igmr-lab/Digital_Galvo/README.md

# Digital Interface for Galvanometers

This project provides a low-cost interface for MachDSP-based galvanometer scanners.
See the manual in the doc folder for further instructions.
