igmr-lab/Digital_Galvo/src/PCB/PCB_2D.png

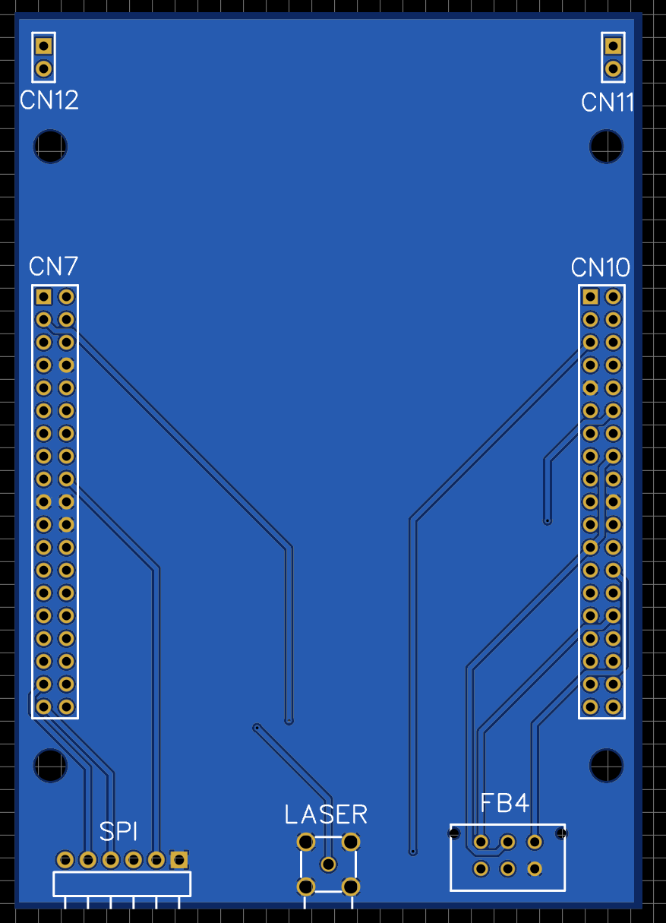
src/PCB/PCB_2D.png
