igmr-lab/Digital_Galvo/src/PCB/PCB_3D.png

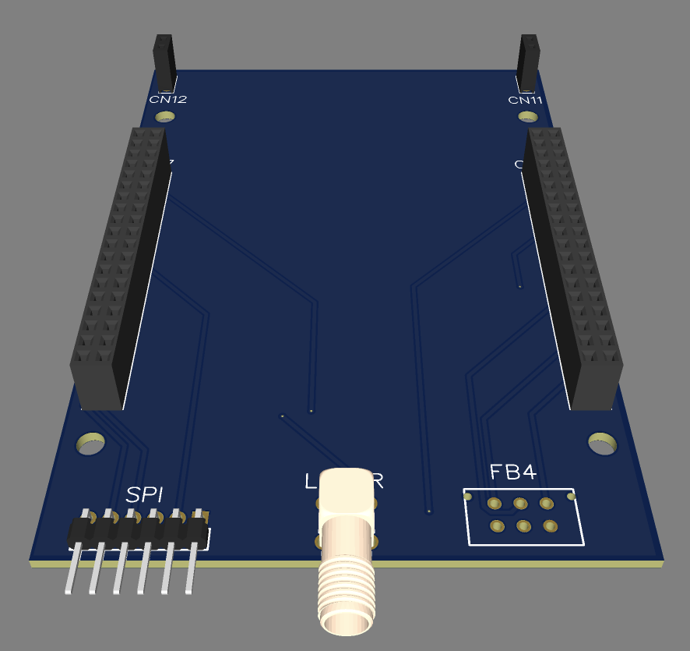
src/PCB/PCB_3D.png
