igmr-lab/Digital_Galvo/src/PCB/PCB_Bottom_Layer.png

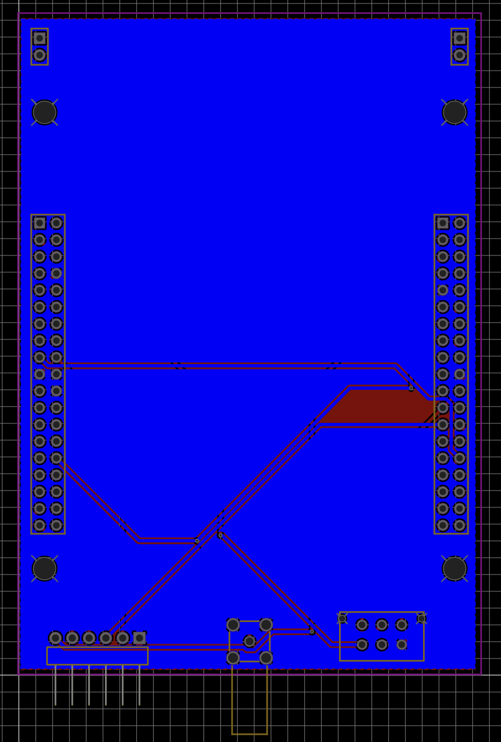
src/PCB/PCB_Bottom_Layer.png
