igmr-lab/Digital_Galvo/src/PCB/PCB_Design.png

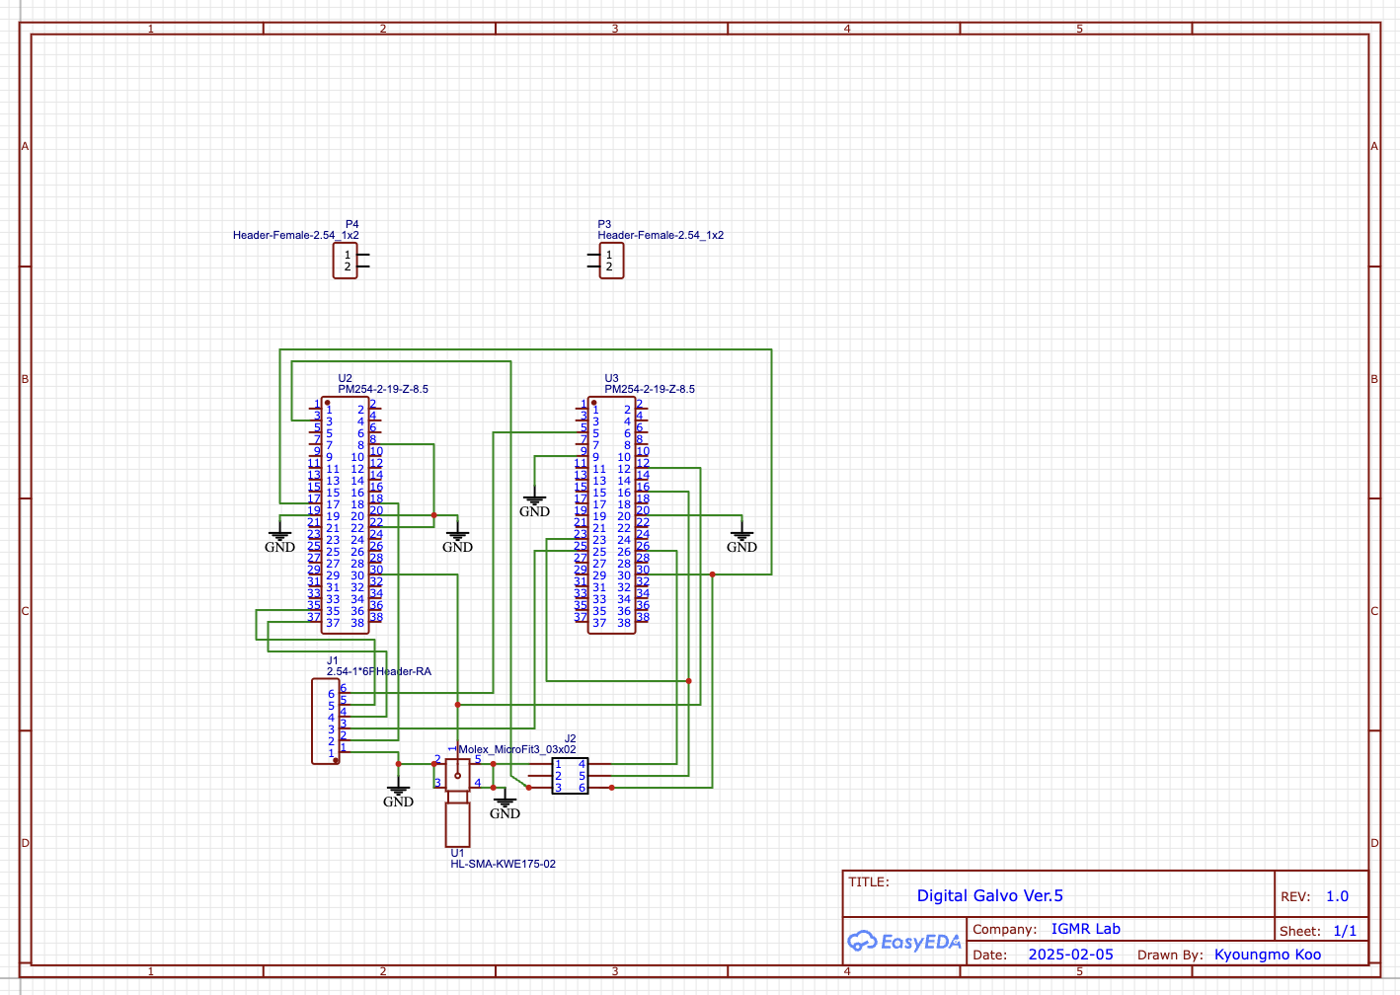
src/PCB/PCB_Design.png
