igmr-lab/Digital_Galvo/src/PCB/PCB_Top_Layer.png

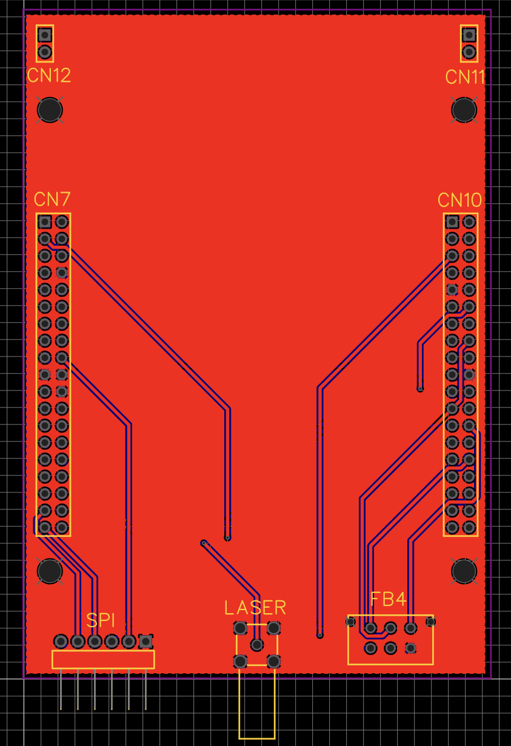
src/PCB/PCB_Top_Layer.png
