igmr-lab/Digital_Galvo/src/STM32/Core/Src/main.c

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
/* Includes ------------------------------------------------------------------*/
#include "main.h"

SAI_HandleTypeDef hsai_BlockA2;
SAI_HandleTypeDef hsai_BlockB2;
DMA_HandleTypeDef hdma_sai2_a;
DMA_HandleTypeDef hdma_sai2_b;

SPI_HandleTypeDef hspi2;
DMA_HandleTypeDef hdma_spi2_rx;
DMA_HandleTypeDef hdma_spi2_tx;

TIM_HandleTypeDef htim1;
TIM_HandleTypeDef htim2;
TIM_HandleTypeDef htim3;
DMA_HandleTypeDef hdma_tim1_ch1;

UART_HandleTypeDef huart1;
UART_HandleTypeDef huart2;
DMA_HandleTypeDef hdma_usart1_tx;
DMA_HandleTypeDef hdma_usart1_rx;
DMA_HandleTypeDef hdma_usart2_tx;
DMA_HandleTypeDef hdma_usart2_rx;

void SystemClock_Config(void);
void PeriphCommonClock_Config(void);
static void MX_GPIO_Init(void);
static void MX_DMA_Init(void);
static void MX_USART2_UART_Init(void);
static void MX_SAI2_Init(void);
static void MX_TIM1_Init(void);
static void MX_TIM2_Init(void);
static void MX_TIM3_Init(void);
static void MX_USART1_UART_Init(void);
static void MX_SPI2_Init(void);
/* USER CODE BEGIN PFP */
uint16_t pwmData[4] = {1, 0, 0, 0};
// uint16_t pwmData[8] = {1, 0, 0, 0, 0, 0, 0, 0};

int COUNT = 32 * 128;
int count = 2;
int BYTE_TO_BITS = 4;
int STATE_DIVIDER = 16;
uint32_t ID = 0x12345678;
uint8_t ping_buffer[4];

int PREP = 1;
int STREAM = 2;
int STOP = 3;
int PING = 4;

int SET_STATE = 1;
int STREAM_STATE = 2;
int STOP_STATE = 3;
int PING_STATE = 4;

int state = 0;
int next_state = 0;
int payload = 0;
int substate = 0;
int toggled = 0;
int NUM_OF_POSITIONS = 0;
int NUM_OF_POSITIONS_PER_CHUNK = 0;
int NUM_OF_BYTES_PER_CHUNK = 0;
int ping = 0;

int test2 = 0;

uint32_t test = 0;
uint32_t txData[6000];
uint32_t rxData[6000];
uint32_t StartByte;


/* USER CODE END PFP */

/* USER CODE BEGIN 0 */

void LED_Toggle(void){

	HAL_GPIO_TogglePin(GPIOA, GPIO_PIN_5);

}

void HAL_UART_TxCpltCallback (UART_HandleTypeDef *huart){

	if(count % 2 == 1){
		HAL_SPI_Transmit_DMA(&hspi2, rxData, NUM_OF_BYTES_PER_CHUNK);
	}
	else if(count % 2 == 0){
		HAL_SPI_Transmit_DMA(&hspi2, &rxData[NUM_OF_POSITIONS_PER_CHUNK], NUM_OF_BYTES_PER_CHUNK + BYTE_TO_BITS);
	}

}

void HAL_UART_RxCpltCallback (UART_HandleTypeDef *huart){

}

void SAI_TransmitReceive (uint16_t DataSize){

	HAL_SAI_Transmit_DMA(&hsai_BlockA2, (uint32_t*)txData, DataSize);
	HAL_SAI_Receive_DMA(&hsai_BlockB2, (uint32_t*)rxData, DataSize);

}

void HAL_SPI_TxCpltCallback (SPI_HandleTypeDef *hspi){

	if(count % 2 == 1){
		HAL_SPI_Receive_DMA(&hspi2, txData, NUM_OF_BYTES_PER_CHUNK);
	}
	else if(count % 2 == 0){
		HAL_SPI_Receive_DMA(&hspi2, &txData[NUM_OF_POSITIONS_PER_CHUNK], NUM_OF_BYTES_PER_CHUNK + BYTE_TO_BITS);
		test= txData[2 * payload];
		if(txData[2 * payload] == STOP){
			state = STOP_STATE;
		}
		if(txData[2 * payload] == 5){
			state = 5;
		}
	}

}

void HAL_SPI_RxCpltCallback (SPI_HandleTypeDef *hspi){
	if(ping == 2){
		ping = 0;
		rxData[2 * NUM_OF_POSITIONS_PER_CHUNK] = 0;
	}
	else if(ping == 1){
		ping = ping + 1;
	}
	if(txData[2 * payload] == PING){
		ping = 1;
		rxData[2 * NUM_OF_POSITIONS_PER_CHUNK] = ID;
	}
}


void HAL_SAI_TxCpltCallback (SAI_HandleTypeDef *hsai){
	LED_Toggle();
	if(ping == 1){
		ping = 0;
	}
	if(state == STOP_STATE){

		HAL_DMA_Abort(hsai_BlockA2.hdmatx);
		HAL_DMA_Abort(hsai_BlockB2.hdmarx);

 		HAL_TIM_PWM_Stop_DMA(&htim1, TIM_CHANNEL_1);
 		HAL_TIM_PWM_Stop(&htim2, TIM_CHANNEL_1);

 		HAL_DMA_DeInit(hsai_BlockA2.hdmatx);
 		HAL_DMA_DeInit(hsai_BlockB2.hdmarx);

 		HAL_SAI_DeInit(&hsai_BlockA2);
 		HAL_SAI_DeInit(&hsai_BlockB2);

 		NVIC_SystemReset();
	}
	if(state == 5){

		HAL_SAI_DMAStop(&hsai_BlockA2);
		HAL_SAI_DMAStop(&hsai_BlockB2);

		__HAL_SAI_DISABLE(&hsai_BlockA2);
		__HAL_SAI_DISABLE(&hsai_BlockB2);

 		HAL_TIM_PWM_Stop_DMA(&htim1, TIM_CHANNEL_1);
 		HAL_TIM_PWM_Stop(&htim2, TIM_CHANNEL_1);

 	  	  while(1){
 	  		  HAL_UART_Receive(&huart2, &StartByte, 4, HAL_MAX_DELAY);
 	  		  next_state = (int16_t)(StartByte >> 16);
 	  		  payload = (int16_t)(StartByte & 0xFFFF);
 	  		  if(next_state == STREAM){
 	  			state = 2;
 	  			SAI_TransmitReceive(NUM_OF_POSITIONS);
 	  			HAL_TIM_PWM_Start_DMA(&htim1, TIM_CHANNEL_1, (uint16_t *)pwmData, 4);
 	  			HAL_TIM_PWM_Start(&htim2, TIM_CHANNEL_1);
 	  			break;
 	  		  }
 	  	  }
	}
	if((state != STOP_STATE) && (count < COUNT + 5)){
		HAL_UART_Transmit_DMA(&huart2, &substate, 1);
		count = count + 1;
		substate = count % STATE_DIVIDER;
		if(count == COUNT + 4){
			NVIC_SystemReset();
		}
	}
}

void HAL_SAI_TxHalfCpltCallback(SAI_HandleTypeDef *hsai){

	if((state == SET_STATE || state == STREAM_STATE) && count < COUNT + 5){
		HAL_UART_Transmit_DMA(&huart2, &substate, 1);
		count = count + 1;
		substate = count % STATE_DIVIDER;
		}

}

/* USER CODE END 0 */

/**
  * @brief  The application entry point.
  * @retval int
  */
int main(void)
{
  /* MCU Configuration--------------------------------------------------------*/

  /* Reset of all peripherals, Initializes the Flash interface and the Systick. */
  HAL_Init();

  /* Configure the system clock */
  SystemClock_Config();

/* Configure the peripherals common clocks */
  PeriphCommonClock_Config();

  /* Initialize all configured peripherals */
  MX_GPIO_Init();
  MX_DMA_Init();
  MX_USART2_UART_Init();
  MX_SAI2_Init();
  MX_TIM1_Init();
  MX_TIM2_Init();
  MX_TIM3_Init();
  MX_USART1_UART_Init();
  MX_SPI2_Init();
  /* USER CODE BEGIN 2 */

  /* blocking the code before Desktop code sends a byte */
  while(1){
	  HAL_UART_Receive(&huart2, &StartByte, 4, HAL_MAX_DELAY);
	  next_state = (int16_t)(StartByte >> 16);
	  payload = (int16_t)(StartByte & 0xFFFF);
	  if(next_state == 1){
		  break;
	  }
	  HAL_Delay(5);
	  ping_buffer[0] = (ID >> 24) & 0xFF;
	  ping_buffer[1] = (ID >> 16) & 0xFF;
	  ping_buffer[2] = (ID >> 8) & 0xFF;
	  ping_buffer[3] = ID & 0xFF;
	  HAL_UART_Transmit(&huart2, ping_buffer, 4, HAL_MAX_DELAY);
  }
  test2 = 1;
    if(next_state == PREP){
  	  state = SET_STATE;

  	  HAL_SPI_Receive_DMA(&hspi2, txData, 2 * payload * sizeof(uint32_t));
  	  txData[2 * payload] = STREAM;

  	  while(1){
  		  HAL_UART_Receive(&huart2, &StartByte, 4, HAL_MAX_DELAY);
  		  next_state = (int16_t)(StartByte >> 16);
  		  payload = (int16_t)(StartByte & 0xFFFF);
  		  if(next_state == STREAM){
  			  break;
  		  }
  		  HAL_Delay(5);
  		  ping_buffer[0] = (ID >> 24) & 0xFF;
  		  ping_buffer[1] = (ID >> 16) & 0xFF;
  		  ping_buffer[2] = (ID >> 8) & 0xFF;
  		  ping_buffer[3] = ID & 0xFF;
  		  HAL_UART_Transmit(&huart2, ping_buffer, 4, HAL_MAX_DELAY);
  	  }

  	  if(next_state == STREAM_STATE){
  		  state = STREAM_STATE;
  		  NUM_OF_POSITIONS = payload * 2;
  		  NUM_OF_POSITIONS_PER_CHUNK = payload;
  		  NUM_OF_BYTES_PER_CHUNK = payload * 4;
  	  }

    }

  /* USER CODE END 2 */

  /* Infinite loop */
  /* USER CODE BEGIN WHILE */

  while (1)
  {
	 /* USER CODE END WHILE */

	 if(toggled == 0){
	      if (HAL_GPIO_ReadPin(GPIOA, GPIO_PIN_1) == GPIO_PIN_SET){
			 	SAI_TransmitReceive(NUM_OF_POSITIONS);
			 	HAL_TIM_PWM_Start_DMA(&htim1, TIM_CHANNEL_1, (uint16_t *)pwmData, 4);
			 	HAL_TIM_PWM_Start(&htim2, TIM_CHANNEL_1);
			 	toggled = 1;
			 }
		}
    /* USER CODE BEGIN 3 */
  }
  /* USER CODE END 3 */
}

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
