igmr-lab/Digital_Galvo/src/STM32/stm32_Vortex_Digital_ver1.ioc

Mcu.UserName=STM32L476RGTx
PA1.Signal=GPIO_Input
PA10.Signal=USART1_RX
PA12.Signal=S_TIM1_ETR
PA2.GPIO_Label=USART_TX
PA2.Signal=USART2_TX
PA3.GPIO_Label=USART_RX
PA3.Signal=USART2_RX
PA5.GPIO_Label=LD2 [green Led]
PA5.Signal=GPIO_Output
PA8.Signal=S_TIM1_CH1
PA9.Signal=GPIO_Output
PB10.Signal=SPI2_SCK
PB12.Signal=SAI2_FS_A
PB13.Signal=SAI2_SCK_A
PB15.Signal=SAI2_SD_A
PB6.Signal=USART1_TX
PB9.Signal=SPI2_NSS
PC12.Signal=SAI2_SD_B
PC13.GPIO_Label=B1 [Blue PushButton]
PC13.Signal=GPXTI13
PC2.Signal=SPI2_MISO
PC3.Signal=SPI2_MOSI
