igmr-lab/Digital_Galvo/(commit log)

2025-06-09 PCB folder made
2025-06-09 PCB images added
